Hexum064/front-wall-leds/rgb-led-board/BOM.xlsx

Comment | Designator | Footprint | JLCPCB Part #（optional）
AP62300 | U1 | TSOT-23-6 | C1883519
3.3uH | L1 | 1008 | C161085
100nF | C1 | 0603 | C1590
22uF | C2 | 0805 | C602037
10uF | C3 | 0805 | C84416
56.2K Ohm | R1 | 0603 | C168337
10k Ohm | R2 | 0603 | C103210
WS2812B | D1,D2,D3,D4,D5,D6,D7 | LED_WS2812B_PLCC4_5.0x5.0mm_P3.2mm | C2920042
