Hexum064/front-wall-leds/CE3PRO_3x5 custom LED housing v2.3mf

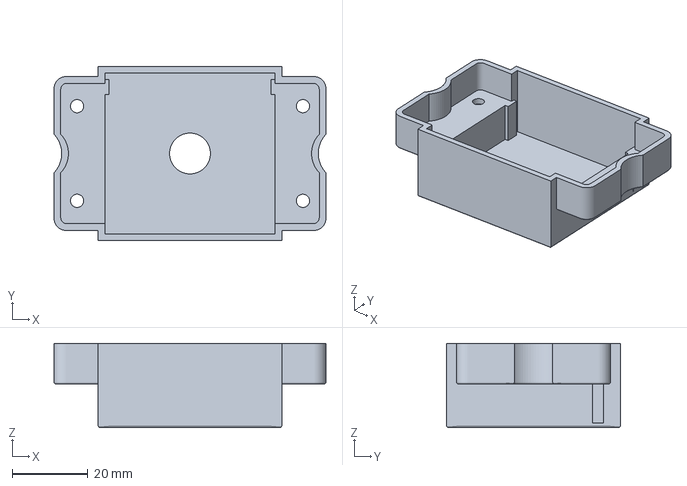
[picture p1: CAD file, 2023-04-20]
CE3PRO_3x5 custom LED housing v2.3mf
71.9 x 46.0 x 22.3 mm
