Hexum064/front-wall-leds/serial-to-ws2812-v2/serial-to-ws2812-v2/serial-to-ws2812-v2.kicad_pcb

## KiCad design serial-to-ws2812-v2/serial-to-ws2812-v2/serial-to-ws2812-v2.kicad_pcb (2023-04-20)

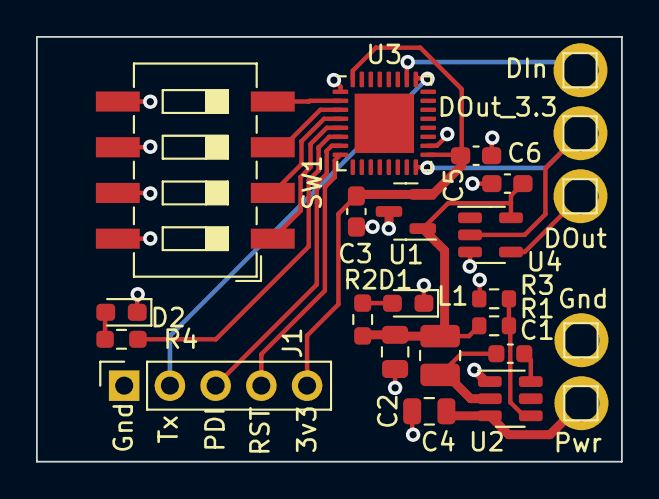
[picture p2: board serial-to-ws2812-v2.kicad_pcb from above]

Board: 2 copper layers, 32.5 x 23.6 mm, 24 parts (0 on the bottom side), 20 nets.

Parts:
C1: 0.1uF; C_0603_1608Metric
C2, C4: 22uF; C_0805_2012Metric
C3: 22uF; C_0603_1608Metric_Pad1.08x0.95mm_HandSolder
C5, C6: 0.1uF; C_0603_1608Metric_Pad1.08x0.95mm_HandSolder
D1, D2: LED_Small; LED_0603_1608Metric_Pad1.05x0.95mm_HandSolder
DIn: DIn; Pin_D0.7mm_L6.5mm_W1.8mm_FlatFork
DOut: DOut_5v; Pin_D0.7mm_L6.5mm_W1.8mm_FlatFork
DOut_3.3: DOut; Pin_D0.7mm_L6.5mm_W1.8mm_FlatFork
Gnd: Gnd; Pin_D0.7mm_L6.5mm_W1.8mm_FlatFork
J1: PRG_DEBUG; PinSocket_1x05_P2.54mm_Vertical
L1: 3.3uH; L_1008_2520Metric
Pwr: Pwr; Pin_D0.7mm_L6.5mm_W1.8mm_FlatFork
R1: 56.2k; R_0603_1608Metric
R2, R4: 1k; R_0603_1608Metric_Pad0.98x0.95mm_HandSolder
R3: 10k; R_0603_1608Metric
SW1: SW_DIP_x04; SW_DIP_SPSTx04_Slide_6.7x11.72mm_W8.61mm_P2.54mm_LowProfile
U1: AP7333-33SAG-7; SOT-23
U2: AP62300; TSOT-23-6
U3: ATxmega32E5-A; QFN-32-1EP_5x5mm_P0.5mm_EP3.3x3.3mm
U4: SN74LV1T34DBV; SOT-23-5

Connections:
+3V3: C3.1, C5.1, J1.5, U1.2 (VO), U3.17 (VCC), U3.32 (AVCC)
+5V: C2.1, C6.1, L1.2, R1.1, R2.1, U1.1 (VI), U4.5 (VCC)
GND: C2.2, C3.2, C4.2, C5.2, C6.2, D1.1 (K), D2.1 (K), Gnd.1, J1.1, R3.2, SW1.5, SW1.6, SW1.7, SW1.8, U1.3 (GND), U2.1 (GND), U3.1 (GND), U3.18 (GND), U4.3 (GND)
unnamed: C1.1, L1.1, U2.2 (SW)
unnamed: C1.2, U2.6 (BST)
unnamed: D1.2 (A), R2.2
unnamed: D2.2 (A), R4.1
unnamed: J1.2, U3.25 (PD3)
unnamed: J1.3, U3.7 (PDI_DATA)
unnamed: J1.4, U3.8 (~RESET/PDI_CLK)
unnamed: DOut_3.3.1, U3.16 (PC0), U4.2 (A)
unnamed: DIn.1, U3.26 (PD2)
unnamed: DOut.1, U4.4 (Y)
unnamed: R1.2, R3.1, U2.4 (FB)
unnamed: R4.2, U3.6 (AREF/PA0)
unnamed: SW1.1, U3.5 (PA1)
unnamed: SW1.2, U3.4 (PA2)
unnamed: SW1.3, U3.3 (PA3)
unnamed: SW1.4, U3.2 (PA4)
VCC: C4.1, Pwr.1, U2.3 (VIN)
