Hexum064/front-wall-leds/rgb-led-board/rgb-led-board.kicad_pcb

## KiCad design rgb-led-board/rgb-led-board.kicad_pcb (2023-04-20)

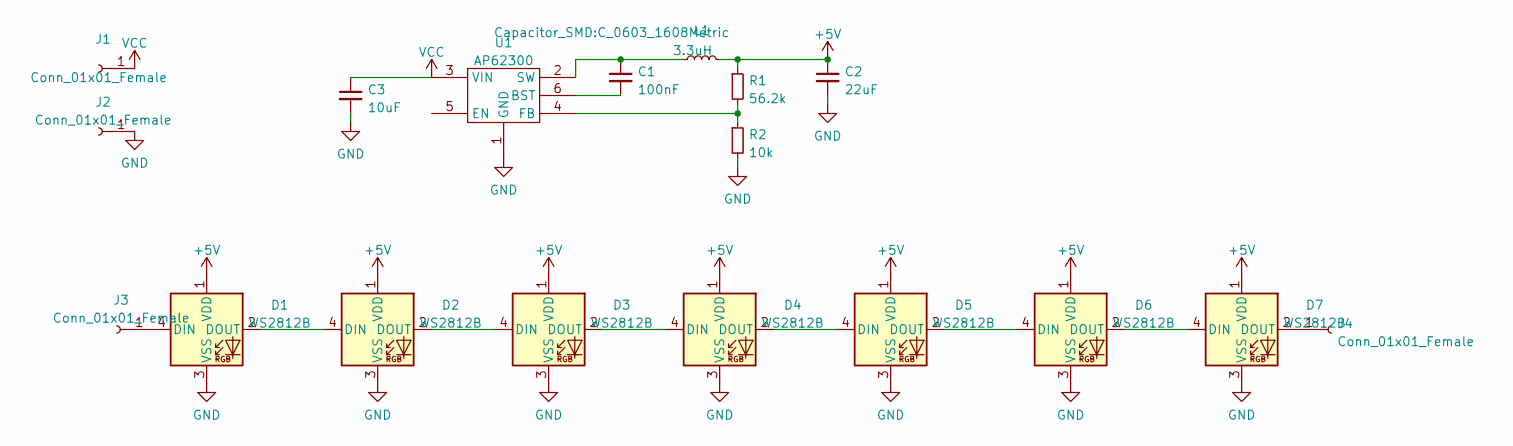
[picture p3: schematic rgb-led-board.kicad_sch]

Parts:
C1: 100nF; C_0603_1608Metric
C2: 22uF; C_0805_2012Metric
C3: 10uF; C_0805_2012Metric
D1, D2, D3, D4, D5, D6, D7: WS2812B; LED_WS2812B_PLCC4_5.0x5.0mm_P3.2mm
J1, J2, J3, J4: Conn_01x01_Female; TestPoint_Plated_Hole_D2.0mm
L1: 3.3uH; L_1008_2520Metric
R1: 56.2k; R_0603_1608Metric
R2: 10k; R_0603_1608Metric
U1: AP62300; TSOT-23-6

Connections:
+5V: C2.1, D1.1 (VDD), D2.1 (VDD), D3.1 (VDD), D4.1 (VDD), D5.1 (VDD), D6.1 (VDD), D7.1 (VDD), L1.2, R1.1
GND: C2.2, C3.2, D1.3 (VSS), D2.3 (VSS), D3.3 (VSS), D4.3 (VSS), D5.3 (VSS), D6.3 (VSS), D7.3 (VSS), J2.1, R2.2, U1.1 (GND)
unnamed: C1.1, L1.1, U1.2 (SW)
unnamed: C1.2, U1.6 (BST)
unnamed: D1.2 (DOUT), D2.4 (DIN)
unnamed: D1.4 (DIN), J3.1
unnamed: D2.2 (DOUT), D3.4 (DIN)
unnamed: D3.2 (DOUT), D4.4 (DIN)
unnamed: D4.2 (DOUT), D5.4 (DIN)
unnamed: D5.2 (DOUT), D6.4 (DIN)
unnamed: D6.2 (DOUT), D7.4 (DIN)
unnamed: D7.2 (DOUT), J4.1
unnamed: R1.2, R2.1, U1.4 (FB)
VCC: C3.1, J1.1, U1.3 (VIN)

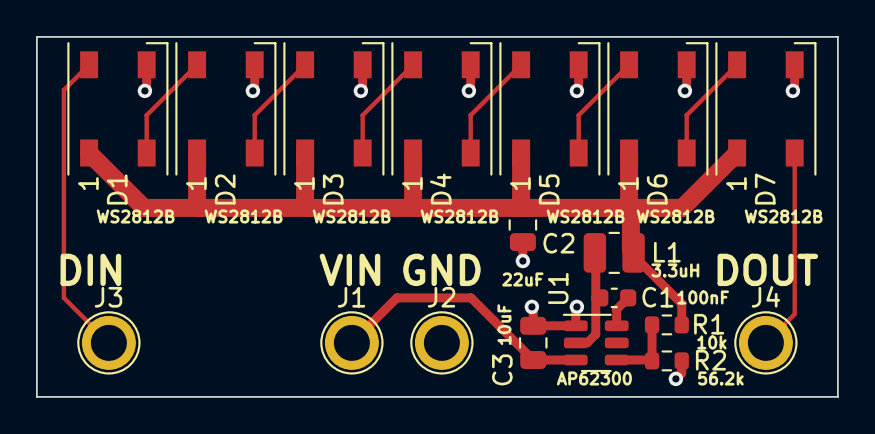
[picture p4: board rgb-led-board.kicad_pcb from above]

Board: 2 copper layers, 44.5 x 20.0 mm, 18 parts (0 on the bottom side), 14 nets.
