Hexum064/front-wall-leds/(commit log)

2023-04-20 init commit
    [BOM.xlsx, CE3PRO_3x5 custom LED housing v2.3mf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]
2023-07-13 moved test-driver
